ericorosel/Pi_grammer/SPI_FLASH_and_BITS_PROGRAMMING/ESP32_PROGRAM/espressif/esp32/doc/esp32_pinmap.png

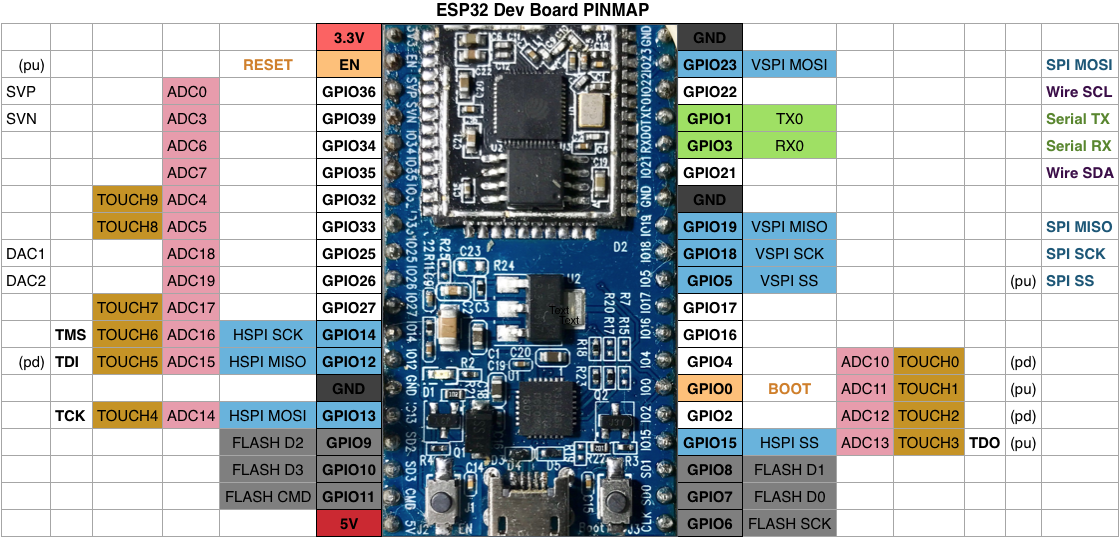
SPI_FLASH_and_BITS_PROGRAMMING/ESP32_PROGRAM/espressif/esp32/doc/esp32_pinmap.png
