ericorosel/Pi_grammer/HARDWARE/ADD-ONS/SPEEDY_SPI_ADD_ON/V3_Logic_Level_Converter/Pi_grammer_SPEEDY_SPI_V3.brd

## EAGLE design HARDWARE/ADD-ONS/SPEEDY_SPI_ADD_ON/V3_Logic_Level_Converter/Pi_grammer_SPEEDY_SPI_V3.brd (2018-01-08)

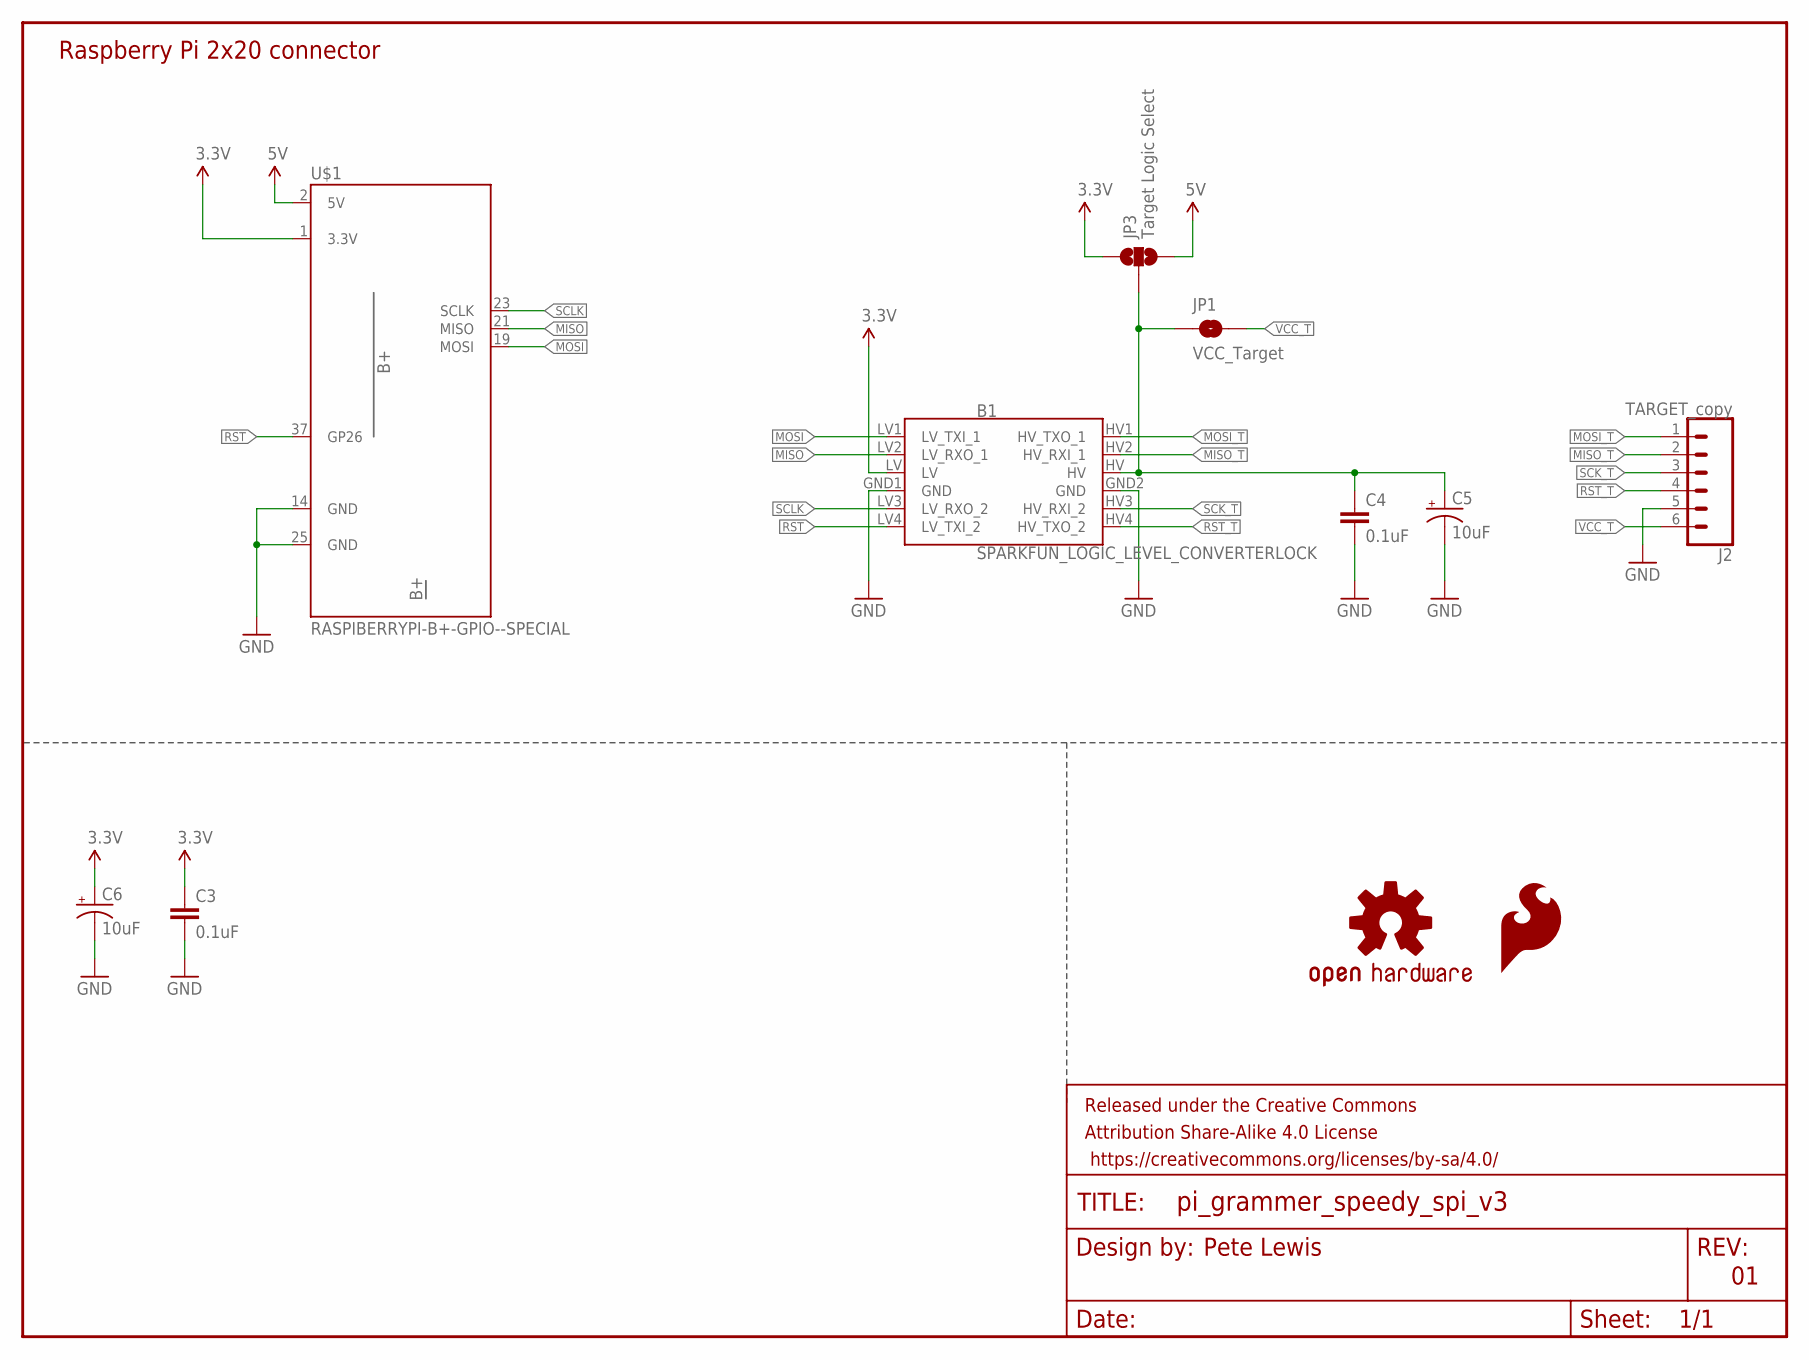
[picture p6: schematic Pi_grammer_SPEEDY_SPI_V3.sch]

Parts:
B1: SPARKFUN_LOGIC_LEVEL_CONVERTERLOCK; SPARKFUN_LOGIC_LEVEL_CONVERTER_LOCK
C3, C4: 0.1uF; 0603
C5, C6: 10uF; EIA3216
FRAME1: FRAME-LETTER; CREATIVE_COMMONS
J2: TARGET_copy; 1X06-SIP_LOCK
JP1: VCC_Target; SMT-JUMPER_2_NO_SILK
JP3: Target Logic Select; SMT-JUMPER_3_NO_SILK
LOGO1: SFE_LOGO_FLAME.1_INCH; SFE_LOGO_FLAME_.1
LOGO2: OSHW-LOGOS; OSHW-LOGO-S
U$1: RASPIBERRYPI-B+-GPIO--SPECIAL; 2X20-SHROUDED--SPECIAL

Connections:
3.3V: B1.LV, C3.1, C6.+, JP3.1, U$1.1 (3.3V)
5V: JP3.3, U$1.2 (5V)
GND: B1.GND1 (GND), B1.GND2 (GND), C3.2, C4.2, C5.-, C6.-, J2.5, U$1.14 (GND), U$1.25 (GND)
MISO: B1.LV2 (LV_RXO_1), U$1.21 (MISO)
MISO_T: B1.HV2 (HV_RXI_1), J2.2
MOSI: B1.LV1 (LV_TXI_1), U$1.19 (MOSI)
MOSI_T: B1.HV1 (HV_TXO_1), J2.1
unnamed: B1.HV, C4.1, C5.+, JP1.1, JP3.2
RST: B1.LV4 (LV_TXI_2), U$1.37 (GP26)
RST_T: B1.HV4 (HV_TXO_2), J2.4
SCK_T: B1.HV3 (HV_RXI_2), J2.3
SCLK: B1.LV3 (LV_RXO_2), U$1.23 (SCLK)
VCC_T: J2.6, JP1.2

Notes on the sheet:
Raspberry Pi 2x20 connector
Pete Lewis

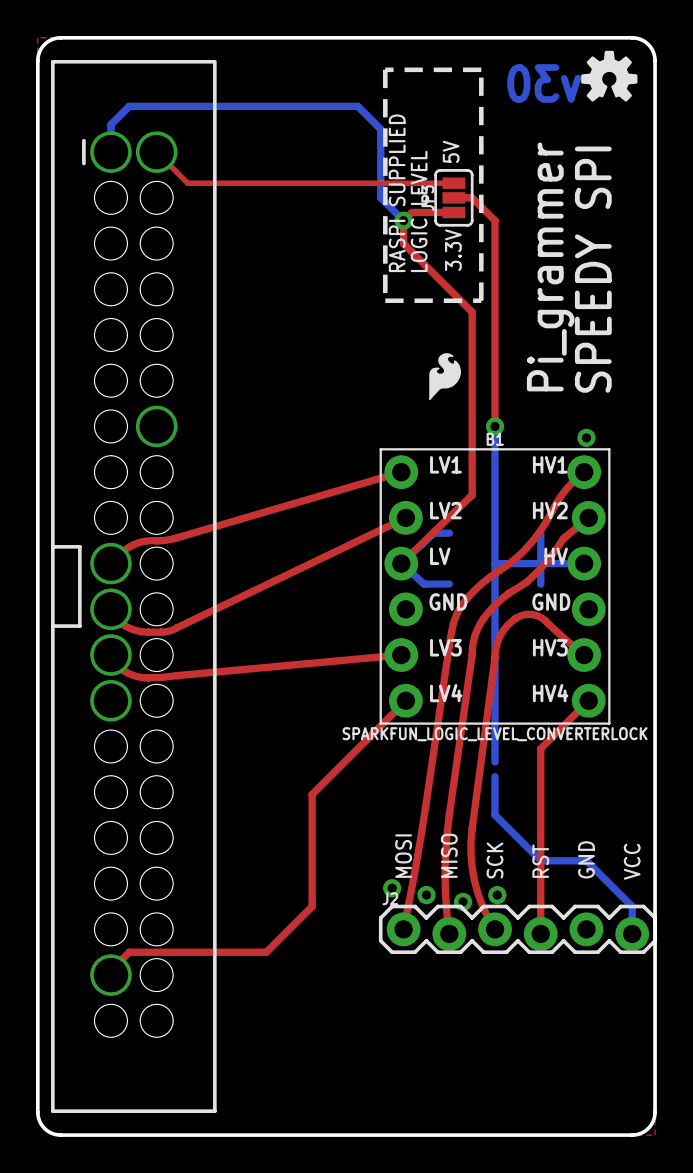
[picture p7: board Pi_grammer_SPEEDY_SPI_V3.brd from above]

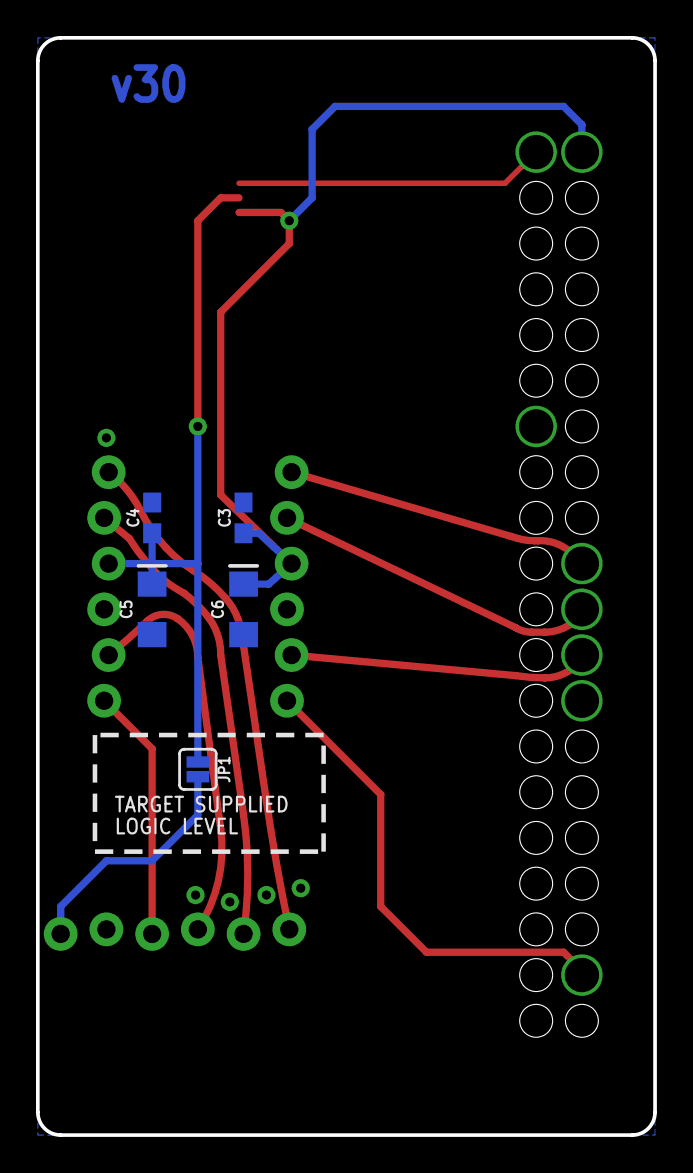
[picture p8: board Pi_grammer_SPEEDY_SPI_V3.brd from below]

Board: 2 copper layers, 34.3 x 61.0 mm, 12 parts (5 on the bottom side), 13 nets.
