ericorosel/Pi_grammer/HARDWARE/JTAG_5-Wire_ADAPTERS/50mil_to_100mil_5x2_adapter/50mil_5x2_JTAG_to_100mil_5x2_v20.brd

## EAGLE design HARDWARE/JTAG_5-Wire_ADAPTERS/50mil_to_100mil_5x2_adapter/50mil_5x2_JTAG_to_100mil_5x2_v20.brd (2018-01-08)

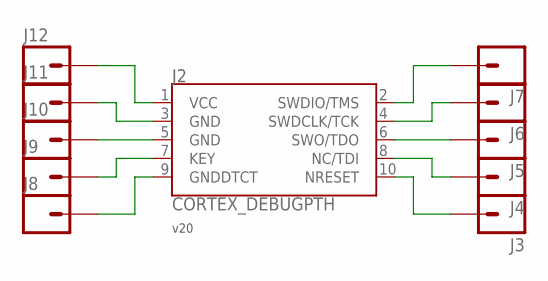
[picture p9: schematic 50mil_5x2_JTAG_to_100mil_5x2_v20.sch]

Parts:
J2: CORTEX_DEBUGPTH; 2X5-PTH-1.27MM
J3, J4, J5, J6, J7, J8, J9, J10, J11, J12: M01OFFSET; 1X01_OFFSET

Connections:
unnamed: J2.10 (NRESET), J3.1
unnamed: J2.8 (NC/TDI), J4.1
unnamed: J2.6 (SWO/TDO), J5.1
unnamed: J2.4 (SWDCLK/TCK), J6.1
unnamed: J2.2 (SWDIO/TMS), J7.1
unnamed: J2.1 (VCC), J12.1
unnamed: J2.3 (GND), J11.1
unnamed: J2.5 (GND), J10.1
unnamed: J2.7 (KEY), J9.1
unnamed: J2.9 (GNDDTCT), J8.1

Notes on the sheet:
v20

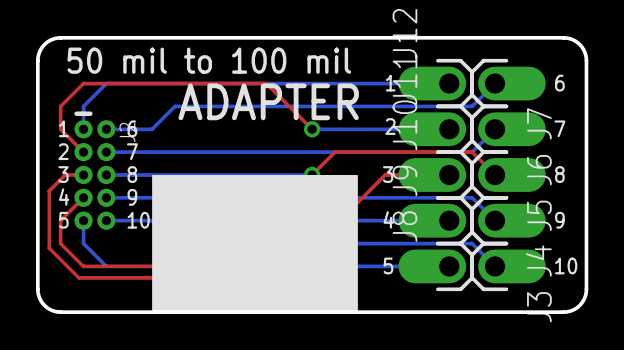
[picture p10: board 50mil_5x2_JTAG_to_100mil_5x2_v20.brd from above]

Board: 2 copper layers, 30.5 x 15.2 mm, 11 parts (0 on the bottom side), 10 nets.
