ericorosel/Pi_grammer/HARDWARE/ADD-ONS/SERIAL_UPLOAD_ADD_ON/Pi_grammer_SERIAL_UPLOAD_ADD_ON.brd

## EAGLE design HARDWARE/ADD-ONS/SERIAL_UPLOAD_ADD_ON/Pi_grammer_SERIAL_UPLOAD_ADD_ON.brd (2018-01-08)

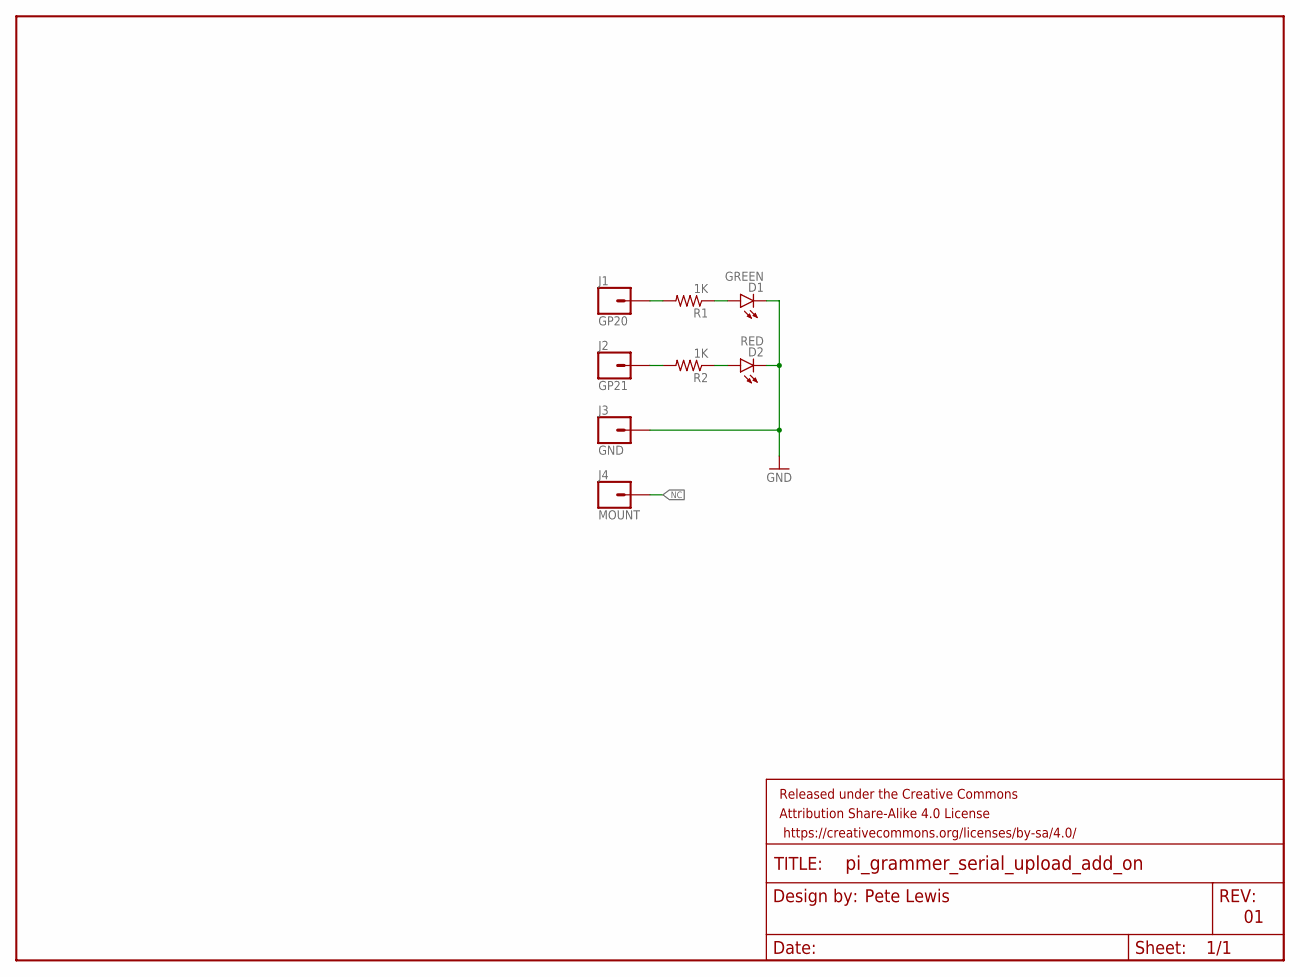
[picture p11: schematic Pi_grammer_SERIAL_UPLOAD_ADD_ON.sch]

Parts:
D1: GREEN; LED-1206
D2: RED; LED-1206
FRAME1: FRAME-LETTER; CREATIVE_COMMONS
J1: GP20; 1X01
J2: GP21; 1X01
J3: GND; 1X01
J4: MOUNT; 1X01
R1, R2: 1K; 0603-RES

Connections:
GND: D1.C, D2.C, J3.1
unnamed: J1.1, R1.2
unnamed: J2.1, R2.2
unnamed: D1.A, R1.1
unnamed: D2.A, R2.1
NC: J4.1

Notes on the sheet:
Pete Lewis

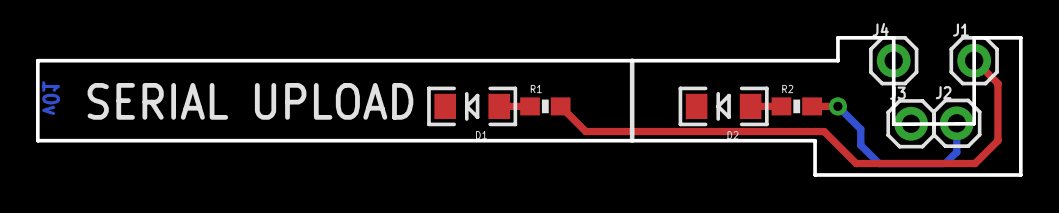
[picture p12: board Pi_grammer_SERIAL_UPLOAD_ADD_ON.brd from above]

Board: 2 copper layers, 54.6 x 7.6 mm, 9 parts (0 on the bottom side), 5 nets.
