ericorosel/Pi_grammer/HARDWARE/MAIN/SINGLE/Pi_grammer_MAIN.brd

## EAGLE design HARDWARE/MAIN/SINGLE/Pi_grammer_MAIN.brd (2018-01-08)

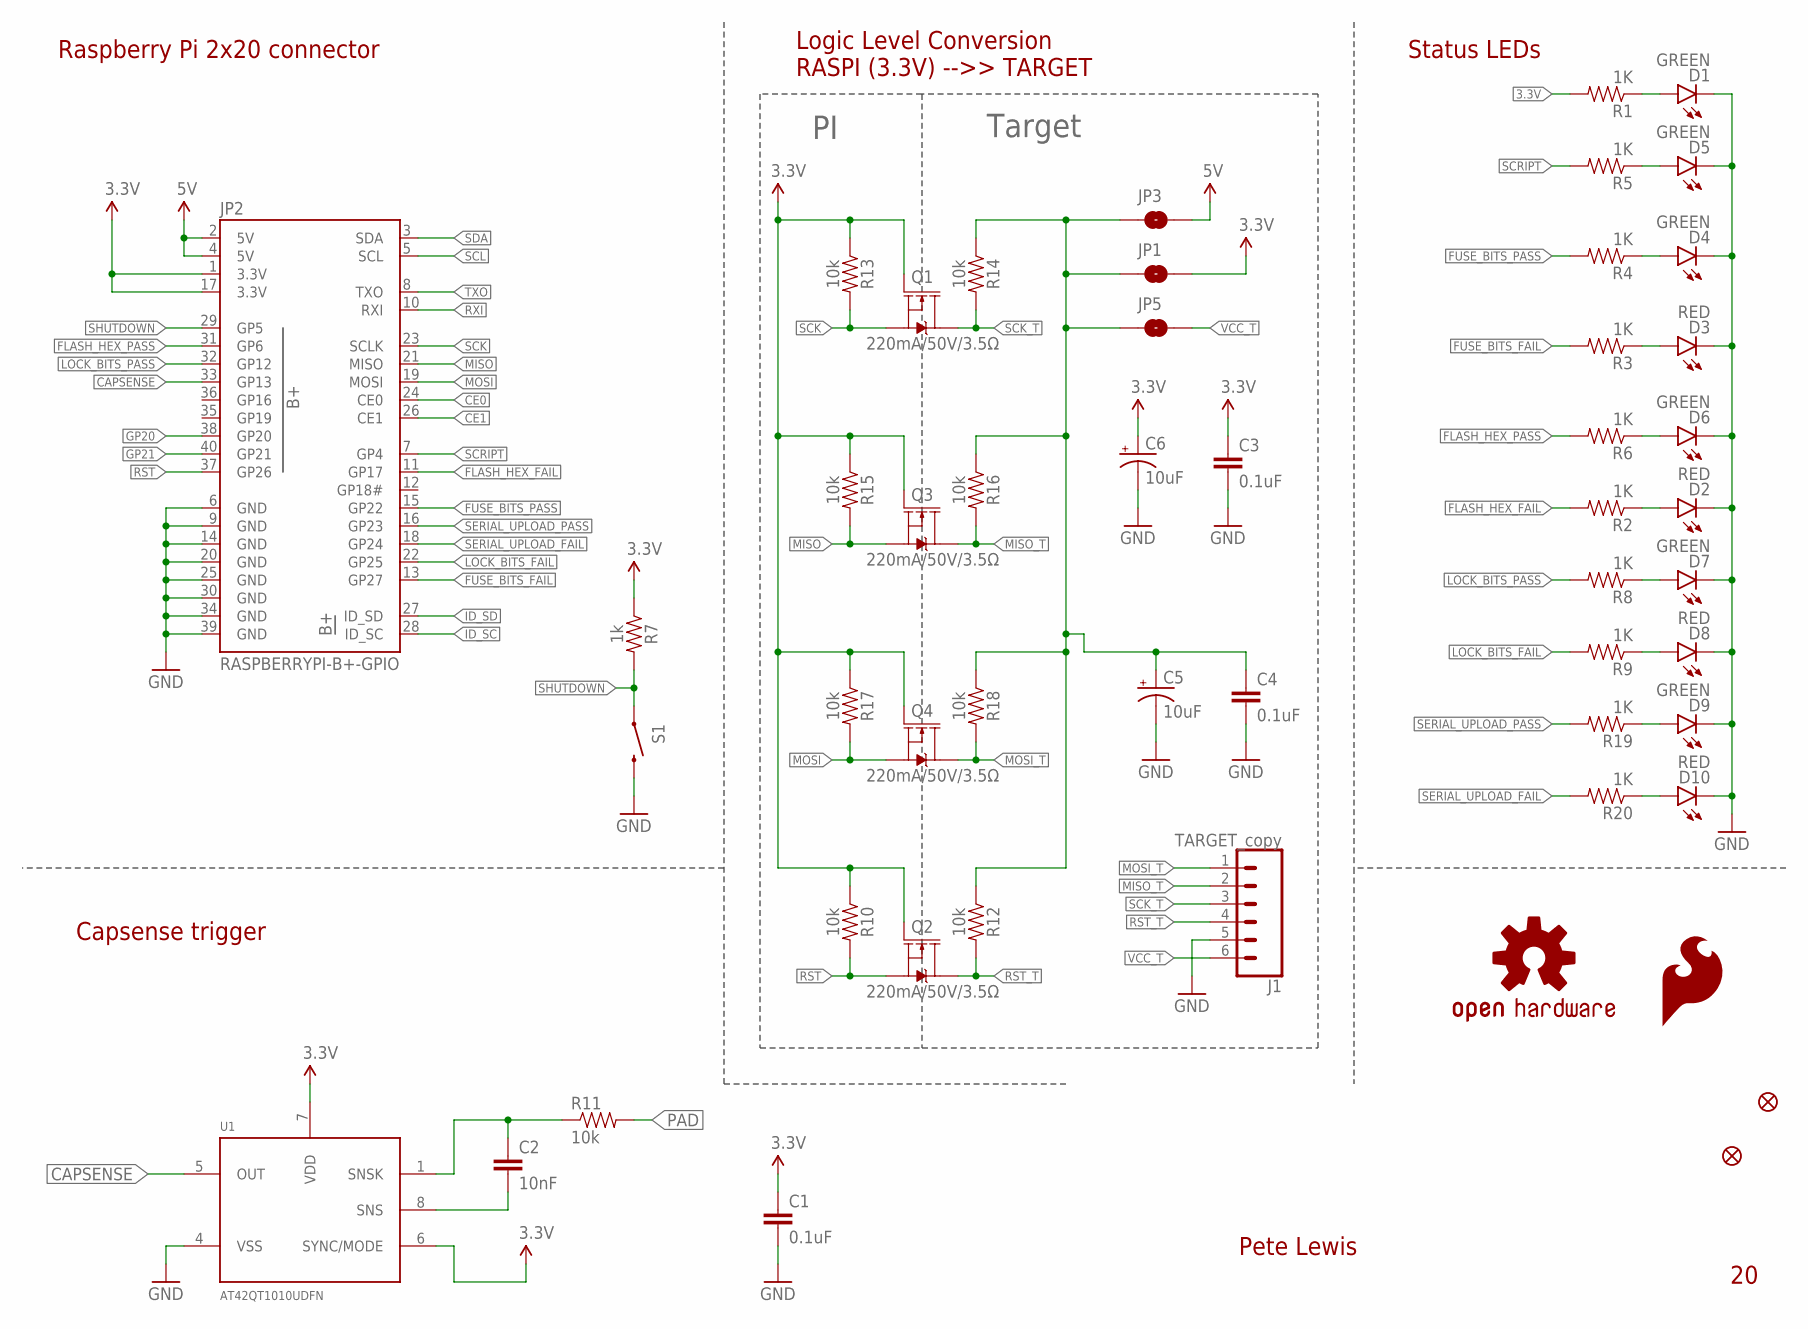
[picture p13: schematic Pi_grammer_MAIN.sch]

Parts:
C1: 0.1uF; 0603-CAP
C2: 10nF; 0603-CAP
C3, C4: 0.1uF; 0603
C5, C6: 10uF; EIA3216
D1, D4, D5, D6, D7, D9: GREEN; LED-1206
D2, D3, D8, D10: RED; LED-1206
FD1, FD2: FIDUCIALUFIDUCIAL; MICRO-FIDUCIAL
J1: TARGET_copy; 1X06_LOCK
JP1, JP3, JP5: JUMPER-SMT_2_NO_SILK; SMT-JUMPER_2_NO_SILK
JP2: RASPBERRYPI-B+-GPIO; 2X20-SHROUDED
LOGO1: SFE_LOGO_FLAME.2_INCH; SFE_LOGO_FLAME_.2
LOGO2: OSHW-LOGOS; OSHW-LOGO-S
Q1, Q2, Q3, Q4: 220mA/50V/3.5Ω; SOT23-3
R1, R2, R3, R4, R5, R6, R8, R9, R19, R20: 1K; 0603-RES
R7: 1k; 0603
R10, R12, R13, R14, R15, R16, R17, R18: 10k; 0603
R11: 10k; 0603-RES
S1: SWITCH-MOMENTARY-2SMD; TACTILE-SWITCH-SMD
U1: AT42QT1010UDFN; UDFN/USON_8_PAD

Connections:
3.3V: C1.1, C3.1, C6.+, JP1.2, JP2.1 (3.3V), JP2.17 (3.3V), Q1.1 (G), Q2.1 (G), Q3.1 (G), Q4.1 (G), R1.2, R7.1, R10.1, R13.1, R15.1, R17.1, U1.6 (SYNC/MODE), U1.7 (VDD)
5V: JP2.2 (5V), JP2.4 (5V), JP3.2
CAPSENSE: JP2.33 (GP13), U1.5 (OUT)
CE0: JP2.24 (CE0)
CE1: JP2.26 (CE1)
FLASH_HEX_FAIL: JP2.11 (GP17), R2.2
FLASH_HEX_PASS: JP2.31 (GP6), R6.2
FUSE_BITS_FAIL: JP2.13 (GP27), R3.2
FUSE_BITS_PASS: JP2.15 (GP22), R4.2
GND: C1.2, C3.2, C4.2, C5.-, C6.-, D1.C, D2.C, D3.C, D4.C, D5.C, D6.C, D7.C, D8.C, D9.C, D10.C, J1.5, JP2.6 (GND), JP2.9 (GND), JP2.14 (GND), JP2.20 (GND), JP2.25 (GND), JP2.30 (GND), JP2.34 (GND), JP2.39 (GND), S1.3 (2), U1.4 (VSS)
GP20: JP2.38 (GP20)
GP21: JP2.40 (GP21)
ID_SC: JP2.28 (ID_SC)
ID_SD: JP2.27 (ID_SD)
LOCK_BITS_FAIL: JP2.22 (GP25), R9.2
LOCK_BITS_PASS: JP2.32 (GP12), R8.2
MISO: JP2.21 (MISO), Q3.2 (S), R15.2
MISO_T: J1.2, Q3.3 (D), R16.2
MOSI: JP2.19 (MOSI), Q4.2 (S), R17.2
MOSI_T: J1.1, Q4.3 (D), R18.2
unnamed: D6.A, R6.1
unnamed: D1.A, R1.1
unnamed: D2.A, R2.1
unnamed: D3.A, R3.1
unnamed: D7.A, R8.1
unnamed: D4.A, R4.1
unnamed: D5.A, R5.1
unnamed: D8.A, R9.1
unnamed: C4.1, C5.+, JP1.1, JP3.1, JP5.1, R12.1, R14.1, R16.1, R18.1
unnamed: C2.2, U1.8 (SNS)
unnamed: C2.1, R11.1, U1.1 (SNSK)
unnamed: D9.A, R19.1
unnamed: D10.A, R20.1
PAD: R11.2
RST: JP2.37 (GP26), Q2.2 (S), R10.2
RST_T: J1.4, Q2.3 (D), R12.2
RXI: JP2.10 (RXI)
SCK: JP2.23 (SCLK), Q1.2 (S), R13.2
SCK_T: J1.3, Q1.3 (D), R14.2
SCL: JP2.5 (SCL)
SCRIPT: JP2.7 (GP4), R5.2
SDA: JP2.3 (SDA)
SERIAL_UPLOAD_FAIL: JP2.18 (GP24), R20.2
SERIAL_UPLOAD_PASS: JP2.16 (GP23), R19.2
SHUTDOWN: JP2.29 (GP5), R7.2, S1.1
TXO: JP2.8 (TXO)
VCC_T: J1.6, JP5.2

Notes on the sheet:
Raspberry Pi 2x20 connector
Pete Lewis
Status LEDs
Capsense trigger
Target
Logic Level Conversion RASPI (3.3V) -->> TARGET

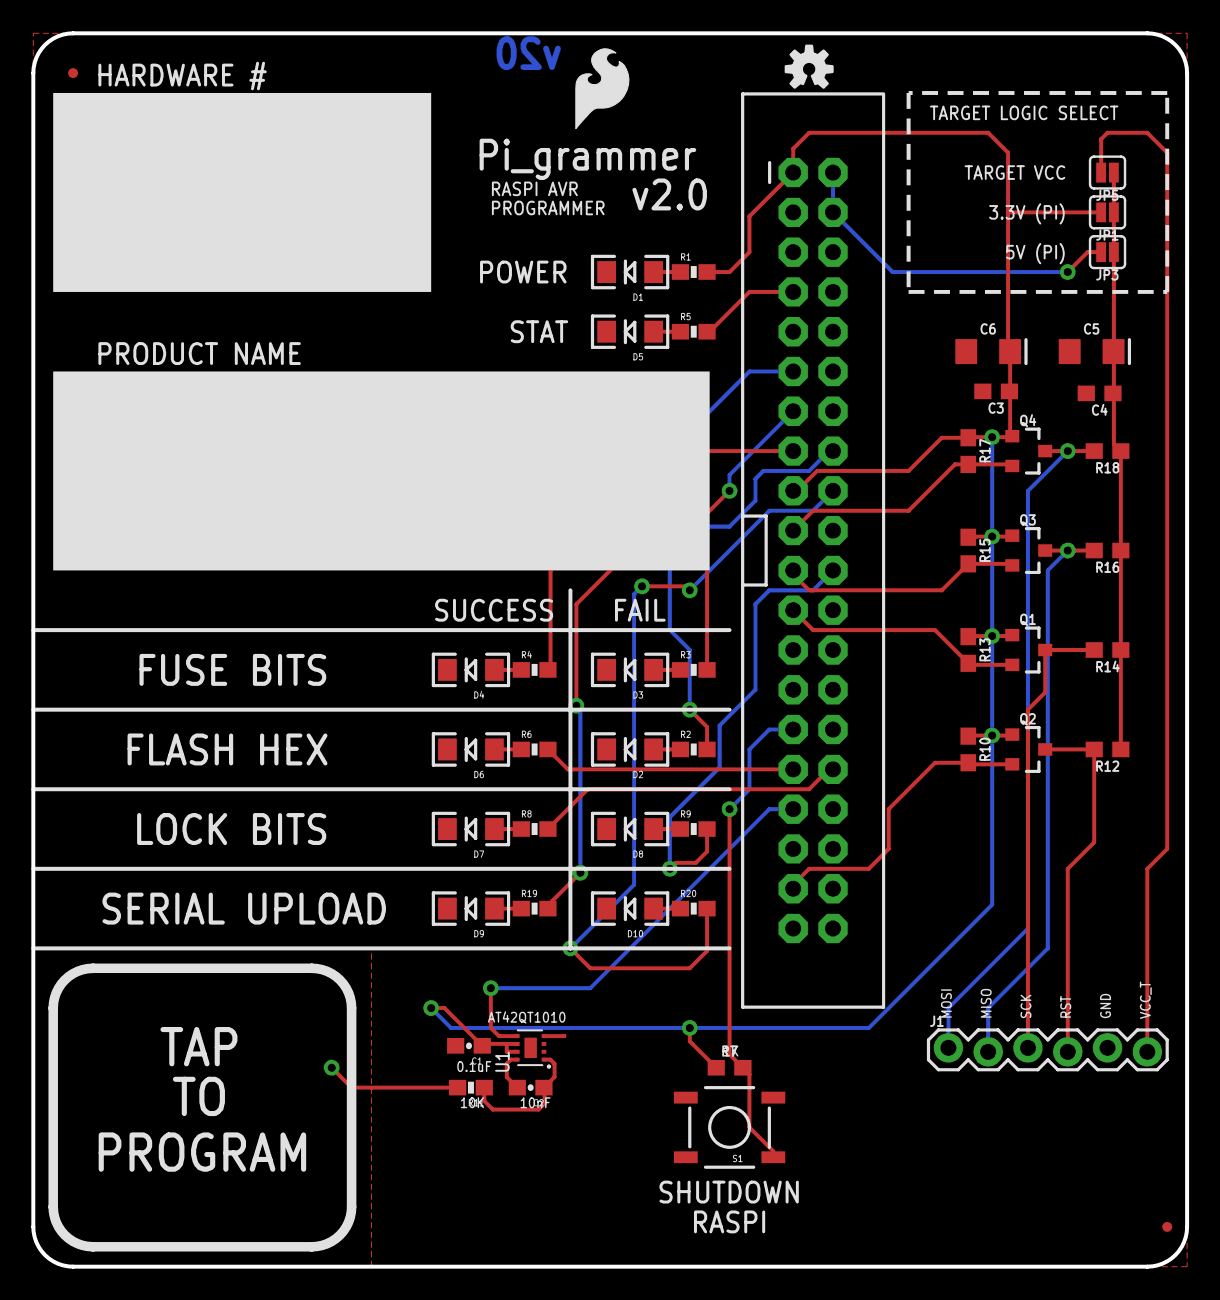
[picture p14: board Pi_grammer_MAIN.brd from above]

Board: 2 copper layers, 73.7 x 78.7 mm, 51 parts (0 on the bottom side), 36 nets.
