ericorosel/Pi_grammer/HARDWARE/1x6_to_2x3_ADAPTER/Pi_grammer_ADAPTER.brd

## EAGLE design HARDWARE/1x6_to_2x3_ADAPTER/Pi_grammer_ADAPTER.brd (2018-01-08)

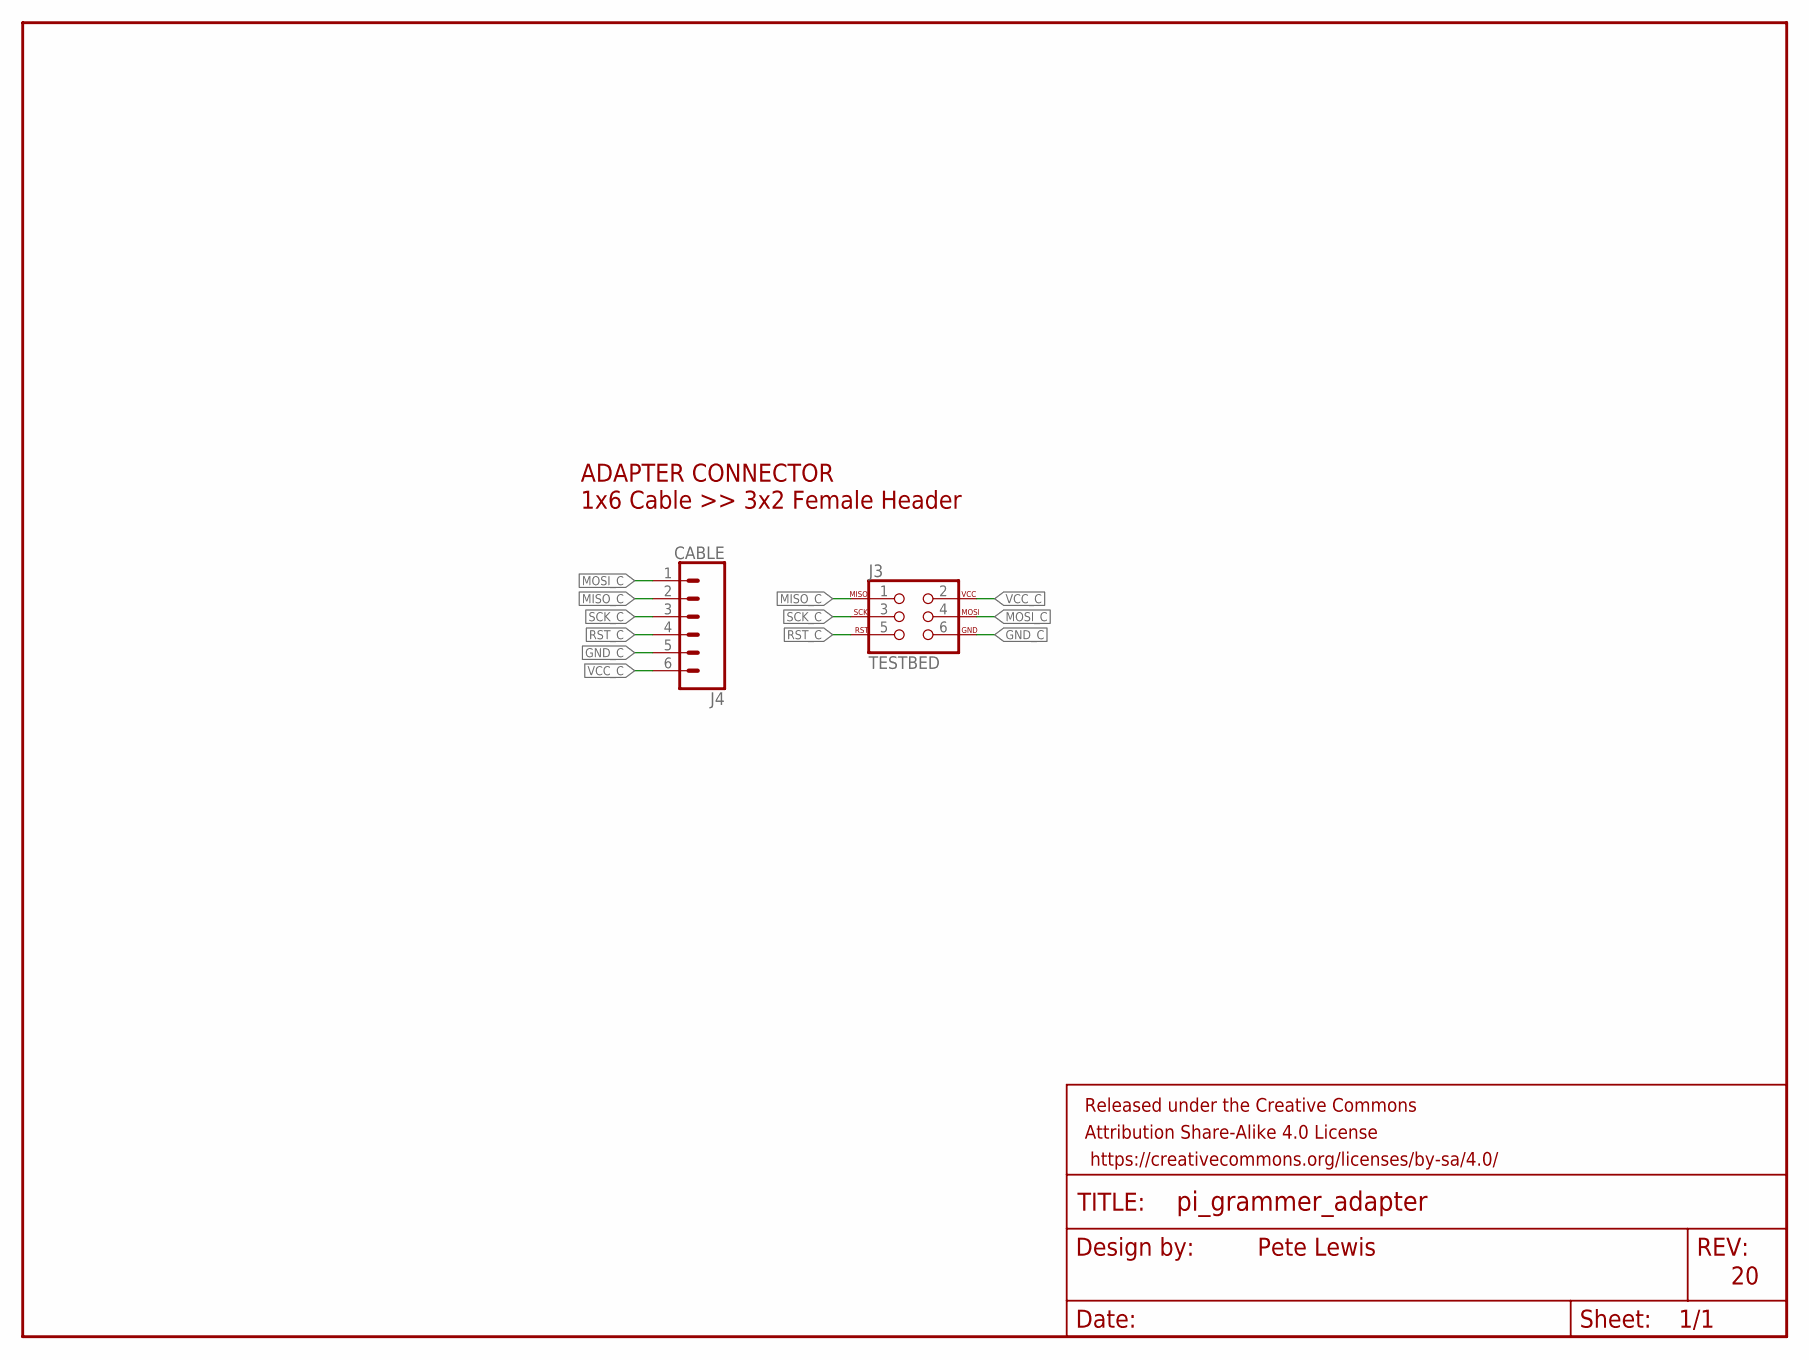
[picture p15: schematic Pi_grammer_ADAPTER.sch]

Parts:
FRAME1: FRAME-LETTER; CREATIVE_COMMONS
J3: TESTBED; 2X3_LOCK
J4: CABLE; MOLEX_1X6_RA_LOCK

Connections:
GND_C: J3.6, J4.5
MISO_C: J3.1, J4.2
MOSI_C: J3.4, J4.1
RST_C: J3.5, J4.4
SCK_C: J3.3, J4.3
VCC_C: J3.2, J4.6

Notes on the sheet:
ADAPTER CONNECTOR 1x6 Cable >> 3x2 Female Header
Pete Lewis

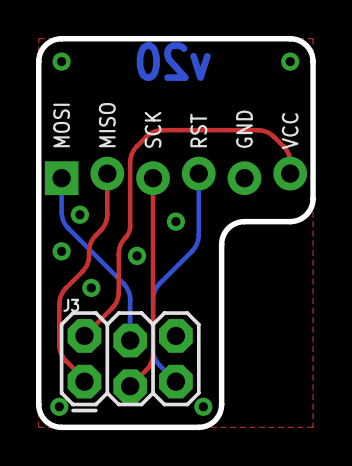
[picture p16: board Pi_grammer_ADAPTER.brd from above]

Board: 2 copper layers, 15.2 x 21.6 mm, 3 parts (1 on the bottom side), 6 nets.
