ericorosel/Pi_grammer/HARDWARE/ADD-ONS/SPEEDY_SPI_ADD_ON/V1_TXB0104/Pi_grammer_SPEEDY_SPI_V1.brd

## EAGLE design HARDWARE/ADD-ONS/SPEEDY_SPI_ADD_ON/V1_TXB0104/Pi_grammer_SPEEDY_SPI_V1.brd (2018-01-08)

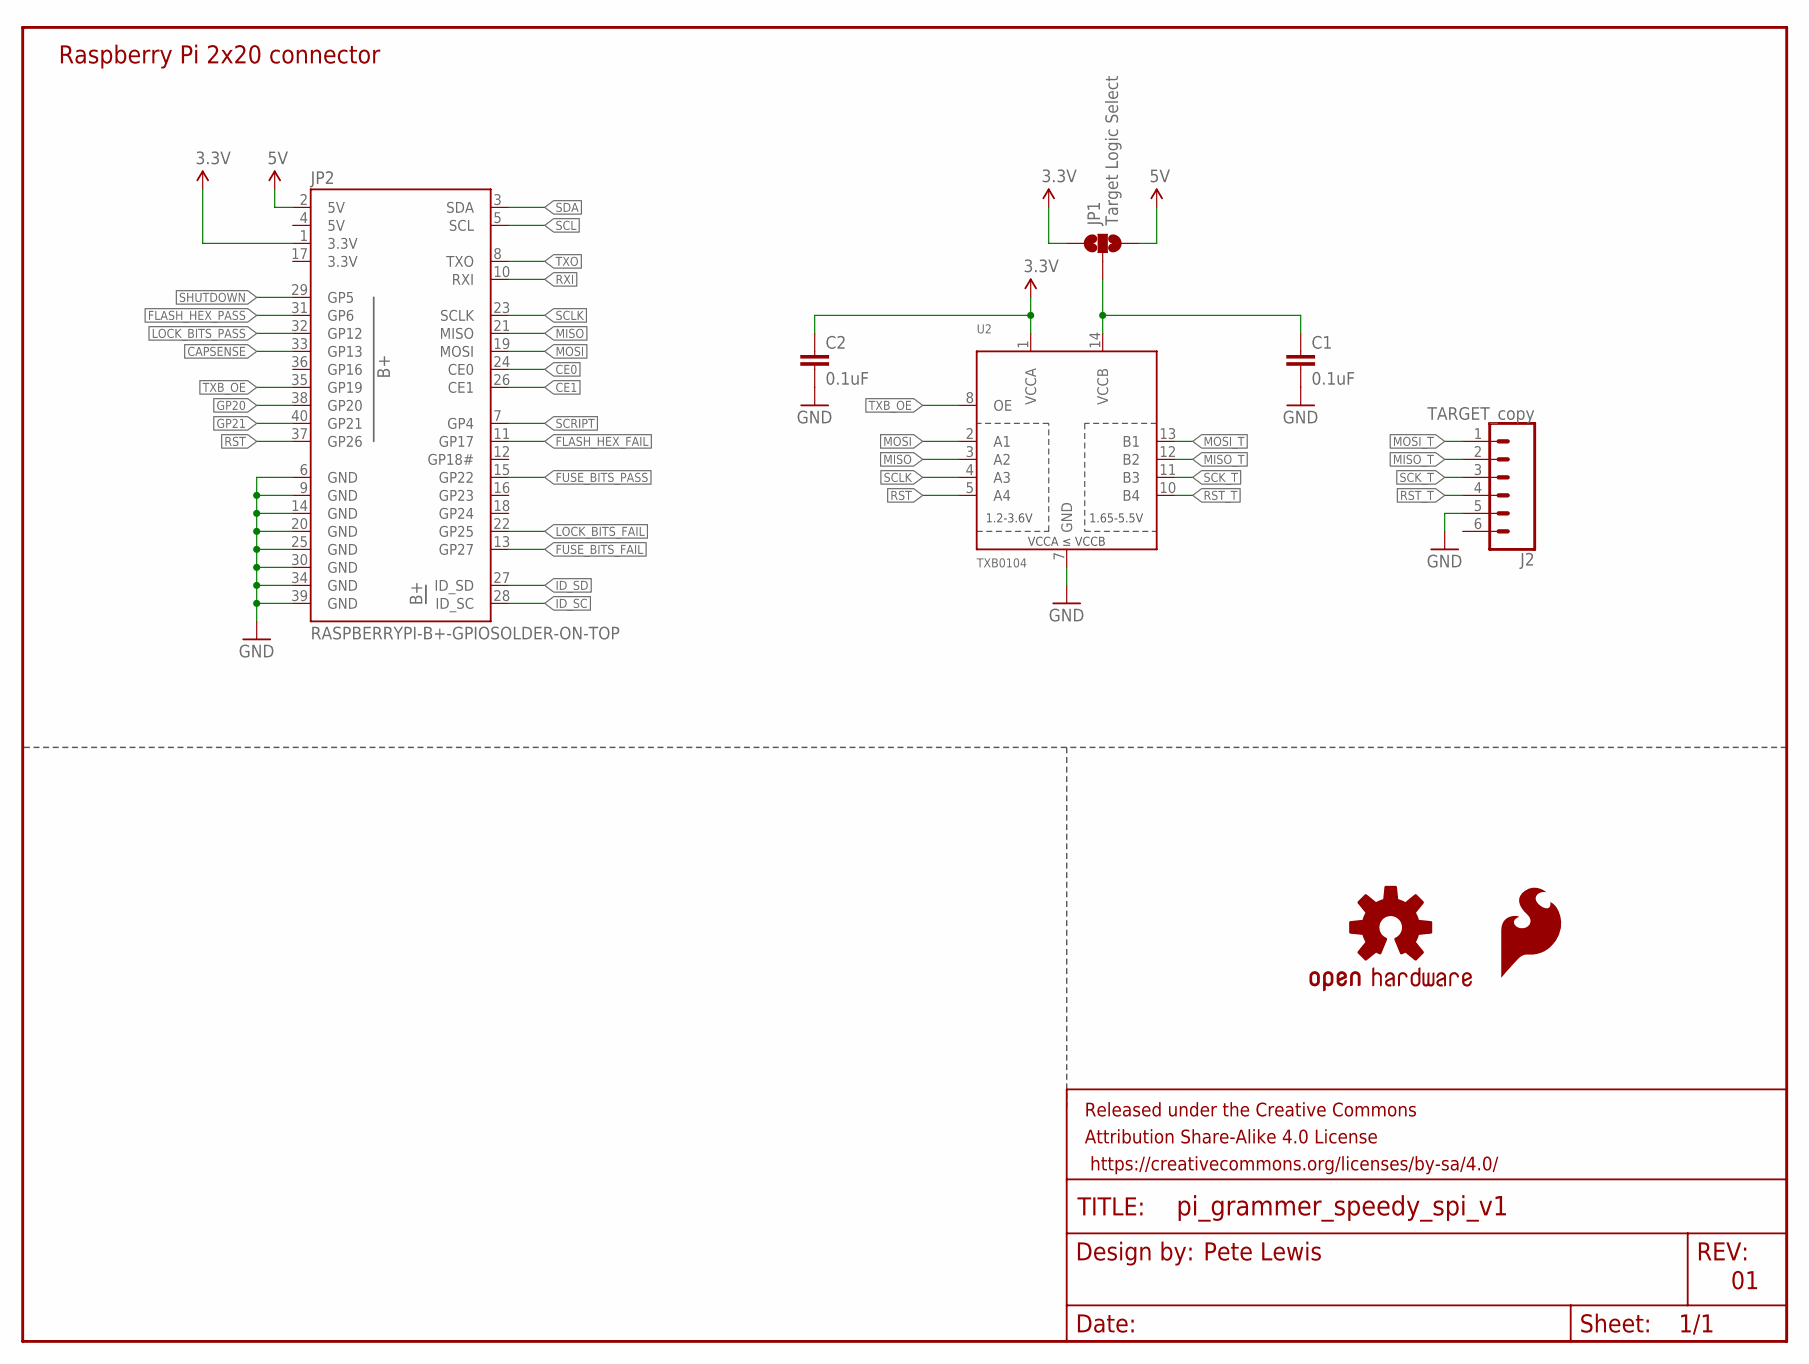
[picture p17: schematic Pi_grammer_SPEEDY_SPI_V1.sch]

Parts:
C1, C2: 0.1uF; 0603
FRAME1: FRAME-LETTER; CREATIVE_COMMONS
J2: TARGET_copy; MOLEX-1X6
JP1: Target Logic Select; SMT-JUMPER_3_NO_SILK
JP2: RASPBERRYPI-B+-GPIOSOLDER-ON-TOP; 2X20-SHROUDED-SOLDER-ON-TOP
LOGO1: SFE_LOGO_FLAME.1_INCH; SFE_LOGO_FLAME_.1
LOGO2: OSHW-LOGOS; OSHW-LOGO-S
U2: TXB0104; SO14

Connections:
3.3V: C2.1, JP1.1, JP2.1 (3.3V), JP2.17 (3.3V), U2.1 (VCCA)
5V: JP1.3, JP2.2 (5V), JP2.4 (5V)
CAPSENSE: JP2.33 (GP13)
CE0: JP2.24 (CE0)
CE1: JP2.26 (CE1)
FLASH_HEX_FAIL: JP2.11 (GP17)
FLASH_HEX_PASS: JP2.31 (GP6)
FUSE_BITS_FAIL: JP2.13 (GP27)
FUSE_BITS_PASS: JP2.15 (GP22)
GND: C1.2, C2.2, J2.5, JP2.6 (GND), JP2.9 (GND), JP2.14 (GND), JP2.20 (GND), JP2.25 (GND), JP2.30 (GND), JP2.34 (GND), JP2.39 (GND), U2.7 (GND)
GP20: JP2.38 (GP20)
GP21: JP2.40 (GP21)
ID_SC: JP2.28 (ID_SC)
ID_SD: JP2.27 (ID_SD)
LOCK_BITS_FAIL: JP2.22 (GP25)
LOCK_BITS_PASS: JP2.32 (GP12)
MISO: JP2.21 (MISO), U2.3 (A2)
MISO_T: J2.2, U2.12 (B2)
MOSI: JP2.19 (MOSI), U2.2 (A1)
MOSI_T: J2.1, U2.13 (B1)
unnamed: C1.1, JP1.2, U2.14 (VCCB)
RST: JP2.37 (GP26), U2.5 (A4)
RST_T: J2.4, U2.10 (B4)
RXI: JP2.10 (RXI)
SCK_T: J2.3, U2.11 (B3)
SCL: JP2.5 (SCL)
SCLK: JP2.23 (SCLK), U2.4 (A3)
SCRIPT: JP2.7 (GP4)
SDA: JP2.3 (SDA)
SHUTDOWN: JP2.29 (GP5)
TXB_OE: JP2.35 (GP19), U2.8 (OE)
TXO: JP2.8 (TXO)

Notes on the sheet:
Raspberry Pi 2x20 connector
Pete Lewis

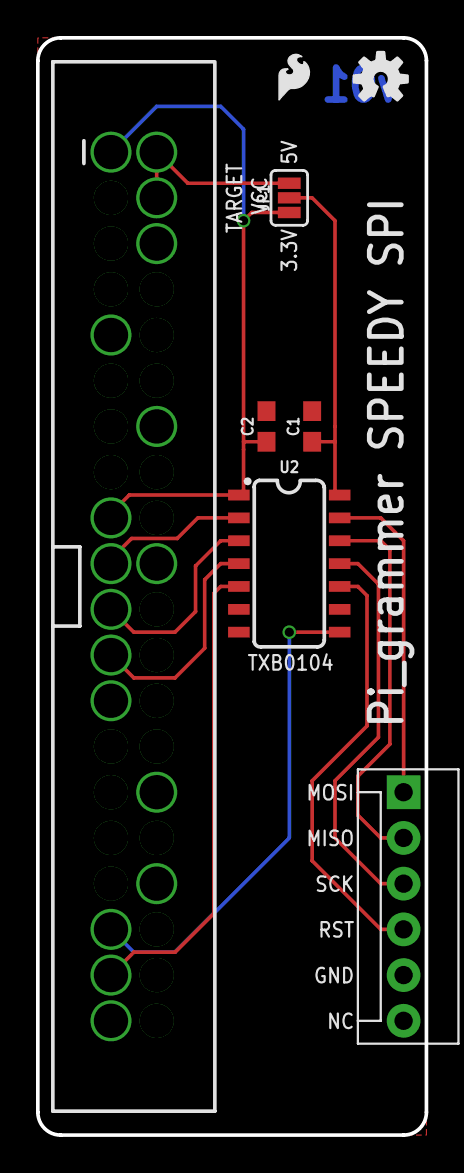
[picture p18: board Pi_grammer_SPEEDY_SPI_V1.brd from above]

Board: 2 copper layers, 21.6 x 61.0 mm, 9 parts (0 on the bottom side), 13 nets.
