ericorosel/Pi_grammer/HARDWARE/MAIN/Production/13490-Pi_grammer_MAIN-panel.v10.brd

## EAGLE design HARDWARE/MAIN/Production/13490-Pi_grammer_MAIN-panel.v10.brd (2018-01-08)

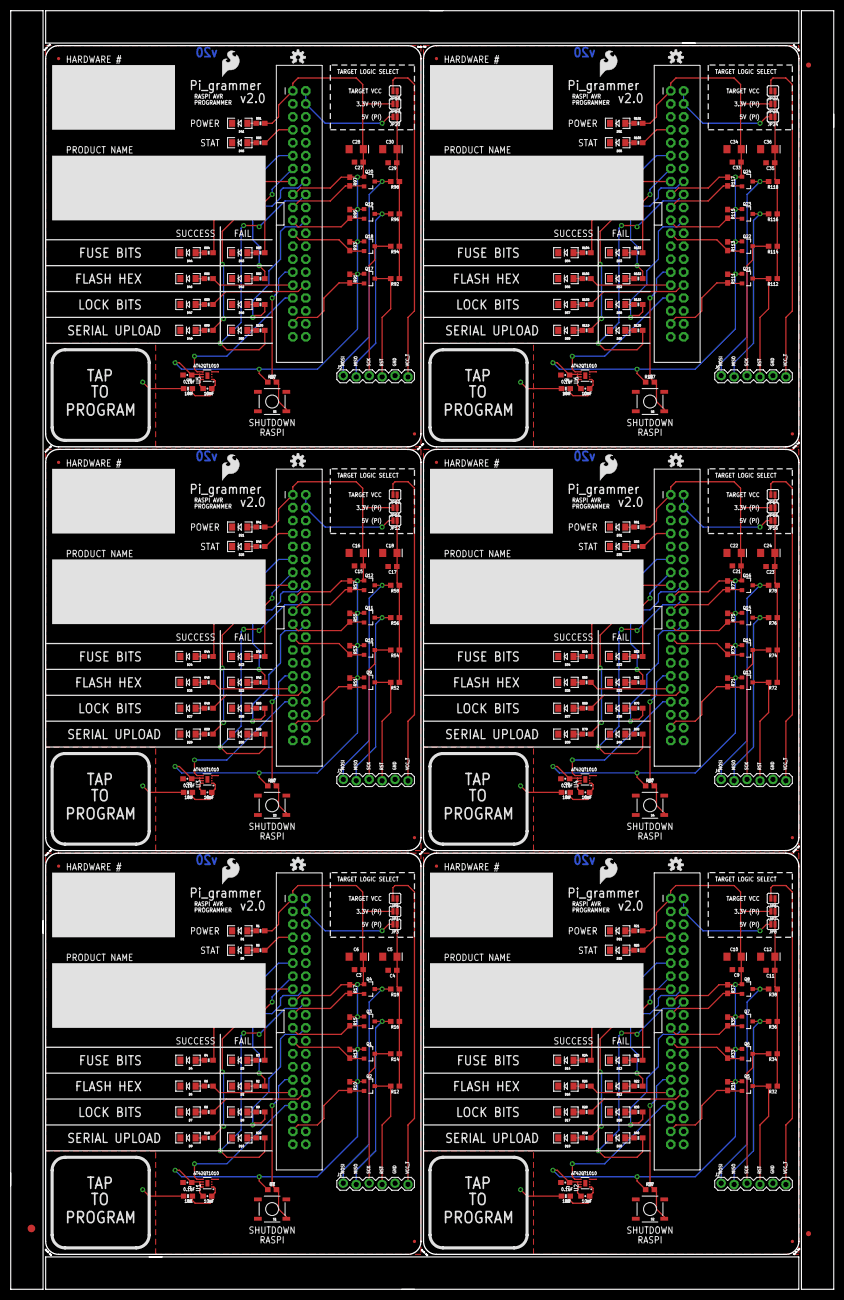
[picture p19: board 13490-Pi_grammer_MAIN-panel.v10.brd from above]

Board: 2 copper layers, 161.5 x 251.0 mm, 309 parts (0 on the bottom side), 216 nets.

Parts:
C1, C7, C13, C19, C25, C31: 0.1uF; 0603-CAP
C2, C8, C14, C20, C26, C32: 10nF; 0603-CAP
C3, C4, C9, C11, C15, C17, C21, C23, C27, C29, C33, C35: 0.1uF; 0603
C5, C6, C10, C12, C16, C18, C22, C24, C28, C30, C34, C36: 10uF; EIA3216
D1, D4, D5, D6, D7, D9, D11, D14, D15, D16, D17, D19, D21, D24, D25, D26, D27, D29, D31, D34, D35, D36, D37, D39, D41, D44, D45, D46, D47, D49, D51, D54, D55, D56, D57, D59: GREEN; LED-1206
D2, D3, D8, D10, D12, D13, D18, D20, D22, D23, D28, D30, D32, D33, D38, D40, D42, D43, D48, D50, D52, D53, D58, D60: RED; LED-1206
E$1: FIDUCIAL-1.5X3
E$7, E$8: FIDUCIAL-1X2
FD1, FD2, FD3, FD4, FD5, FD6, FD7, FD8, FD9, FD10, FD11, FD12: FIDUCIALUFIDUCIAL; MICRO-FIDUCIAL
J1, J2, J3, J4, J5, J6: TARGET_copy; 1X06_LOCK
JP1, JP3, JP5, JP6, JP7, JP8, JP10, JP11, JP12, JP14, JP15, JP16, JP18, JP19, JP20, JP22, JP23, JP24: SMT-JUMPER_2_NO_SILK
JP2, JP4, JP9, JP13, JP17, JP21: RASPBERRYPI-B+-GPIO; 2X20-SHROUDED
LOGO1, LOGO4, LOGO6, LOGO8, LOGO10, LOGO12: SFE_LOGO_FLAME.2_INCH; SFE_LOGO_FLAME_.2
LOGO2, LOGO3, LOGO5, LOGO7, LOGO9, LOGO11: OSHW-LOGOS; OSHW-LOGO-S
Q1, Q2, Q3, Q4, Q5, Q6, Q7, Q8, Q9, Q10, Q11, Q12, Q13, Q14, Q15, Q16, Q17, Q18, Q19, Q20, Q21, Q22, Q23, Q24: 220mA/50V/3.5Ω; SOT23-3
R1, R2, R3, R4, R5, R6, R8, R9, R19, R20, R21, R22, R23, R24, R25, R26, R28, R30, R39, R40, R41, R42, R43, R44, R45, R46, R48, R50, R59, R60, R61, R62, R63, R64, R65, R66, R68, R70, R79, R80, R81, R82, R83, R84, R85, R86, R88, R90, R99, R100, R101, R102, R103, R104, R105, R106, R108, R110, R119, R120: 1K; 0603-RES
R7, R27, R47, R67, R87, R107: 1k; 0603
R10, R12, R13, R14, R15, R16, R17, R18, R31, R32, R33, R34, R35, R36, R37, R38, R51, R52, R53, R54, R55, R56, R57, R58, R71, R72, R73, R74, R75, R76, R77, R78, R91, R92, R93, R94, R95, R96, R97, R98, R111, R112, R113, R114, R115, R116, R117, R118: 10k; 0603
R11, R29, R49, R69, R89, R109: 10k; 0603-RES
S1, S2, S3, S4, S5, S6: TACTILE-SWITCH-SMD
U1, U2, U3, U4, U5, U6: AT42QT1010UDFN; UDFN/USON_8_PAD

Connections:
3.3V: C1.1, C3.1, C6.+, JP1.2, JP2.1, JP2.17, Q1.1, Q2.1, Q3.1, Q4.1, R1.2, R7.1, R10.1, R13.1, R15.1, R17.1, U1.6, U1.7
3.3V1: C7.1, C9.1, C10.+, JP4.1, JP4.17, JP7.2, Q5.1, Q6.1, Q7.1, Q8.1, R21.2, R27.1, R31.1, R33.1, R35.1, R37.1, U2.6, U2.7
3.3V2: C13.1, C15.1, C16.+, JP9.1, JP9.17, JP11.2, Q9.1, Q10.1, Q11.1, Q12.1, R41.2, R47.1, R51.1, R53.1, R55.1, R57.1, U3.6, U3.7
3.3V3: C19.1, C21.1, C22.+, JP13.1, JP13.17, JP15.2, Q13.1, Q14.1, Q15.1, Q16.1, R61.2, R67.1, R71.1, R73.1, R75.1, R77.1, U4.6, U4.7
3.3V4: C25.1, C27.1, C28.+, JP17.1, JP17.17, JP19.2, Q17.1, Q18.1, Q19.1, Q20.1, R81.2, R87.1, R91.1, R93.1, R95.1, R97.1, U5.6, U5.7
3.3V5: C31.1, C33.1, C34.+, JP21.1, JP21.17, JP23.2, Q21.1, Q22.1, Q23.1, Q24.1, R101.2, R107.1, R111.1, R113.1, R115.1, R117.1, U6.6, U6.7
5V: JP2.2, JP2.4, JP3.2
5V1: JP4.2, JP4.4, JP8.2
5V2: JP9.2, JP9.4, JP12.2
5V3: JP13.2, JP13.4, JP16.2
5V4: JP17.2, JP17.4, JP20.2
5V5: JP21.2, JP21.4, JP24.2
CAPSENSE: JP2.33, U1.5
CAPSENSE1: JP4.33, U2.5
CAPSENSE2: JP9.33, U3.5
CAPSENSE3: JP13.33, U4.5
CAPSENSE4: JP17.33, U5.5
CAPSENSE5: JP21.33, U6.5
FLASH_HEX_FAIL: JP2.11, R2.2
FLASH_HEX_FAIL1: JP4.11, R22.2
FLASH_HEX_FAIL2: JP9.11, R42.2
FLASH_HEX_FAIL3: JP13.11, R62.2
FLASH_HEX_FAIL4: JP17.11, R82.2
FLASH_HEX_FAIL5: JP21.11, R102.2
FLASH_HEX_PASS: JP2.31, R6.2
FLASH_HEX_PASS1: JP4.31, R26.2
FLASH_HEX_PASS2: JP9.31, R46.2
FLASH_HEX_PASS3: JP13.31, R66.2
FLASH_HEX_PASS4: JP17.31, R86.2
FLASH_HEX_PASS5: JP21.31, R106.2
FUSE_BITS_FAIL: JP2.13, R3.2
FUSE_BITS_FAIL1: JP4.13, R23.2
FUSE_BITS_FAIL2: JP9.13, R43.2
FUSE_BITS_FAIL3: JP13.13, R63.2
FUSE_BITS_FAIL4: JP17.13, R83.2
FUSE_BITS_FAIL5: JP21.13, R103.2
FUSE_BITS_PASS: JP2.15, R4.2
FUSE_BITS_PASS1: JP4.15, R24.2
FUSE_BITS_PASS2: JP9.15, R44.2
FUSE_BITS_PASS3: JP13.15, R64.2
FUSE_BITS_PASS4: JP17.15, R84.2
FUSE_BITS_PASS5: JP21.15, R104.2
GND: C1.2, C3.2, C4.2, C5.-, C6.-, D1.C, D2.C, D3.C, D4.C, D5.C, D6.C, D7.C, D8.C, D9.C, D10.C, J1.5, JP2.6, JP2.9, JP2.14, JP2.20, JP2.25, JP2.30, JP2.34, JP2.39, S1.3, U1.4
GND1: C7.2, C9.2, C10.-, C11.2, C12.-, D11.C, D12.C, D13.C, D14.C, D15.C, D16.C, D17.C, D18.C, D19.C, D20.C, J2.5, JP4.6, JP4.9, JP4.14, JP4.20, JP4.25, JP4.30, JP4.34, JP4.39, S2.3, U2.4
GND2: C13.2, C15.2, C16.-, C17.2, C18.-, D21.C, D22.C, D23.C, D24.C, D25.C, D26.C, D27.C, D28.C, D29.C, D30.C, J3.5, JP9.6, JP9.9, JP9.14, JP9.20, JP9.25, JP9.30, JP9.34, JP9.39, S3.3, U3.4
GND3: C19.2, C21.2, C22.-, C23.2, C24.-, D31.C, D32.C, D33.C, D34.C, D35.C, D36.C, D37.C, D38.C, D39.C, D40.C, J4.5, JP13.6, JP13.9, JP13.14, JP13.20, JP13.25, JP13.30, JP13.34, JP13.39, S4.3, U4.4
GND4: C25.2, C27.2, C28.-, C29.2, C30.-, D41.C, D42.C, D43.C, D44.C, D45.C, D46.C, D47.C, D48.C, D49.C, D50.C, J5.5, JP17.6, JP17.9, JP17.14, JP17.20, JP17.25, JP17.30, JP17.34, JP17.39, S5.3, U5.4
GND5: C31.2, C33.2, C34.-, C35.2, C36.-, D51.C, D52.C, D53.C, D54.C, D55.C, D56.C, D57.C, D58.C, D59.C, D60.C, J6.5, JP21.6, JP21.9, JP21.14, JP21.20, JP21.25, JP21.30, JP21.34, JP21.39, S6.3, U6.4
LOCK_BITS_FAIL: JP2.22, R9.2
LOCK_BITS_FAIL1: JP4.22, R30.2
LOCK_BITS_FAIL2: JP9.22, R50.2
LOCK_BITS_FAIL3: JP13.22, R70.2
LOCK_BITS_FAIL4: JP17.22, R90.2
LOCK_BITS_FAIL5: JP21.22, R110.2
LOCK_BITS_PASS: JP2.32, R8.2
LOCK_BITS_PASS1: JP4.32, R28.2
LOCK_BITS_PASS2: JP9.32, R48.2
LOCK_BITS_PASS3: JP13.32, R68.2
LOCK_BITS_PASS4: JP17.32, R88.2
LOCK_BITS_PASS5: JP21.32, R108.2
MISO: JP2.21, Q3.2, R15.2
MISO1: JP4.21, Q7.2, R35.2
MISO2: JP9.21, Q11.2, R55.2
MISO3: JP13.21, Q15.2, R75.2
MISO4: JP17.21, Q19.2, R95.2
MISO5: JP21.21, Q23.2, R115.2
MISO_T: J1.2, Q3.3, R16.2
MISO_T1: J2.2, Q7.3, R36.2
MISO_T2: J3.2, Q11.3, R56.2
MISO_T3: J4.2, Q15.3, R76.2
MISO_T4: J5.2, Q19.3, R96.2
MISO_T5: J6.2, Q23.3, R116.2
MOSI: JP2.19, Q4.2, R17.2
MOSI1: JP4.19, Q8.2, R37.2
MOSI2: JP9.19, Q12.2, R57.2
MOSI3: JP13.19, Q16.2, R77.2
MOSI4: JP17.19, Q20.2, R97.2
MOSI5: JP21.19, Q24.2, R117.2
MOSI_T: J1.1, Q4.3, R18.2
MOSI_T1: J2.1, Q8.3, R38.2
MOSI_T2: J3.1, Q12.3, R58.2
MOSI_T3: J4.1, Q16.3, R78.2
MOSI_T4: J5.1, Q20.3, R98.2
MOSI_T5: J6.1, Q24.3, R118.2
unnamed: D6.A, R6.1
unnamed: D1.A, R1.1
unnamed: D2.A, R2.1
unnamed: D3.A, R3.1
unnamed: D7.A, R8.1
unnamed: D4.A, R4.1
unnamed: D5.A, R5.1
unnamed: D8.A, R9.1
unnamed: C4.1, C5.+, JP1.1, JP3.1, JP5.1, R12.1, R14.1, R16.1, R18.1
unnamed: C2.2, U1.8
unnamed: C2.1, R11.1, U1.1
unnamed: D11.A, R21.1
unnamed: D9.A, R19.1
unnamed: D10.A, R20.1
unnamed: D12.A, R22.1
unnamed: D13.A, R23.1
unnamed: D14.A, R24.1
unnamed: D15.A, R25.1
unnamed: D16.A, R26.1
unnamed: D17.A, R28.1
unnamed: C8.2, U2.8
unnamed: C8.1, R29.1, U2.1
unnamed: D18.A, R30.1
unnamed: D19.A, R39.1
unnamed: D20.A, R40.1
unnamed: C11.1, C12.+, JP6.1, JP7.1, JP8.1, R32.1, R34.1, R36.1, R38.1
unnamed: D21.A, R41.1
unnamed: D22.A, R42.1
unnamed: D23.A, R43.1
unnamed: D24.A, R44.1
unnamed: D25.A, R45.1
unnamed: D26.A, R46.1
unnamed: D27.A, R48.1
unnamed: C14.2, U3.8
unnamed: C14.1, R49.1, U3.1
unnamed: D28.A, R50.1
unnamed: D29.A, R59.1
unnamed: D30.A, R60.1
unnamed: C17.1, C18.+, JP10.1, JP11.1, JP12.1, R52.1, R54.1, R56.1, R58.1
unnamed: D31.A, R61.1
unnamed: D32.A, R62.1
unnamed: D33.A, R63.1
unnamed: D34.A, R64.1
unnamed: D35.A, R65.1
unnamed: D36.A, R66.1
unnamed: D37.A, R68.1
unnamed: C20.2, U4.8
unnamed: C20.1, R69.1, U4.1
unnamed: D38.A, R70.1
unnamed: D39.A, R79.1
unnamed: D40.A, R80.1
unnamed: C23.1, C24.+, JP14.1, JP15.1, JP16.1, R72.1, R74.1, R76.1, R78.1
unnamed: D41.A, R81.1
unnamed: D42.A, R82.1
unnamed: D43.A, R83.1
unnamed: D44.A, R84.1
unnamed: D45.A, R85.1
unnamed: D46.A, R86.1
unnamed: D47.A, R88.1
unnamed: C26.2, U5.8
unnamed: C26.1, R89.1, U5.1
unnamed: D48.A, R90.1
unnamed: D49.A, R99.1
unnamed: D50.A, R100.1
unnamed: C29.1, C30.+, JP18.1, JP19.1, JP20.1, R92.1, R94.1, R96.1, R98.1
unnamed: D51.A, R101.1
unnamed: D52.A, R102.1
unnamed: D53.A, R103.1
unnamed: D54.A, R104.1
unnamed: D55.A, R105.1
unnamed: D56.A, R106.1
unnamed: D57.A, R108.1
unnamed: C32.2, U6.8
unnamed: C32.1, R109.1, U6.1
unnamed: D58.A, R110.1
unnamed: D59.A, R119.1
unnamed: D60.A, R120.1
unnamed: C35.1, C36.+, JP22.1, JP23.1, JP24.1, R112.1, R114.1, R116.1, R118.1
RST: JP2.37, Q2.2, R10.2
RST1: JP4.37, Q5.2, R31.2
RST2: JP9.37, Q9.2, R51.2
RST3: JP13.37, Q13.2, R71.2
RST4: JP17.37, Q17.2, R91.2
RST5: JP21.37, Q21.2, R111.2
RST_T: J1.4, Q2.3, R12.2
RST_T1: J2.4, Q5.3, R32.2
RST_T2: J3.4, Q9.3, R52.2
RST_T3: J4.4, Q13.3, R72.2
RST_T4: J5.4, Q17.3, R92.2
RST_T5: J6.4, Q21.3, R112.2
SCK: JP2.23, Q1.2, R13.2
SCK1: JP4.23, Q6.2, R33.2
SCK2: JP9.23, Q10.2, R53.2
SCK3: JP13.23, Q14.2, R73.2
SCK4: JP17.23, Q18.2, R93.2
SCK5: JP21.23, Q22.2, R113.2
SCK_T: J1.3, Q1.3, R14.2
SCK_T1: J2.3, Q6.3, R34.2
SCK_T2: J3.3, Q10.3, R54.2
SCK_T3: J4.3, Q14.3, R74.2
SCK_T4: J5.3, Q18.3, R94.2
SCK_T5: J6.3, Q22.3, R114.2
SCRIPT: JP2.7, R5.2
SCRIPT1: JP4.7, R25.2
SCRIPT2: JP9.7, R45.2
SCRIPT3: JP13.7, R65.2
SCRIPT4: JP17.7, R85.2
SCRIPT5: JP21.7, R105.2
SERIAL_UPLOAD_FAIL: JP2.18, R20.2
SERIAL_UPLOAD_FAIL1: JP4.18, R40.2
SERIAL_UPLOAD_FAIL2: JP9.18, R60.2
SERIAL_UPLOAD_FAIL3: JP13.18, R80.2
SERIAL_UPLOAD_FAIL4: JP17.18, R100.2
SERIAL_UPLOAD_FAIL5: JP21.18, R120.2
SERIAL_UPLOAD_PASS: JP2.16, R19.2
SERIAL_UPLOAD_PASS1: JP4.16, R39.2
SERIAL_UPLOAD_PASS2: JP9.16, R59.2
SERIAL_UPLOAD_PASS3: JP13.16, R79.2
SERIAL_UPLOAD_PASS4: JP17.16, R99.2
SERIAL_UPLOAD_PASS5: JP21.16, R119.2
SHUTDOWN: JP2.29, R7.2, S1.1
SHUTDOWN1: JP4.29, R27.2, S2.1
SHUTDOWN2: JP9.29, R47.2, S3.1
SHUTDOWN3: JP13.29, R67.2, S4.1
SHUTDOWN4: JP17.29, R87.2, S5.1
SHUTDOWN5: JP21.29, R107.2, S6.1
VCC_T: J1.6, JP5.2
VCC_T1: J2.6, JP6.2
VCC_T2: J3.6, JP10.2
VCC_T3: J4.6, JP14.2
VCC_T4: J5.6, JP18.2
VCC_T5: J6.6, JP22.2
